togoreanbogdan/ADAU1446-DSP/README.md

# ADAU1446-DSP
Project for ADAU1446 Audio DSP. The PCB is compatible with all the family ADAU144x.
