togoreanbogdan/ADAU1446-DSP/KiCad/DSP-ADAU1446-core-pcb/DSP-ADAU1446-core-pcb.kicad_pcb

## KiCad design KiCad/DSP-ADAU1446-core-pcb/DSP-ADAU1446-core-pcb.kicad_pcb (2017-08-31)

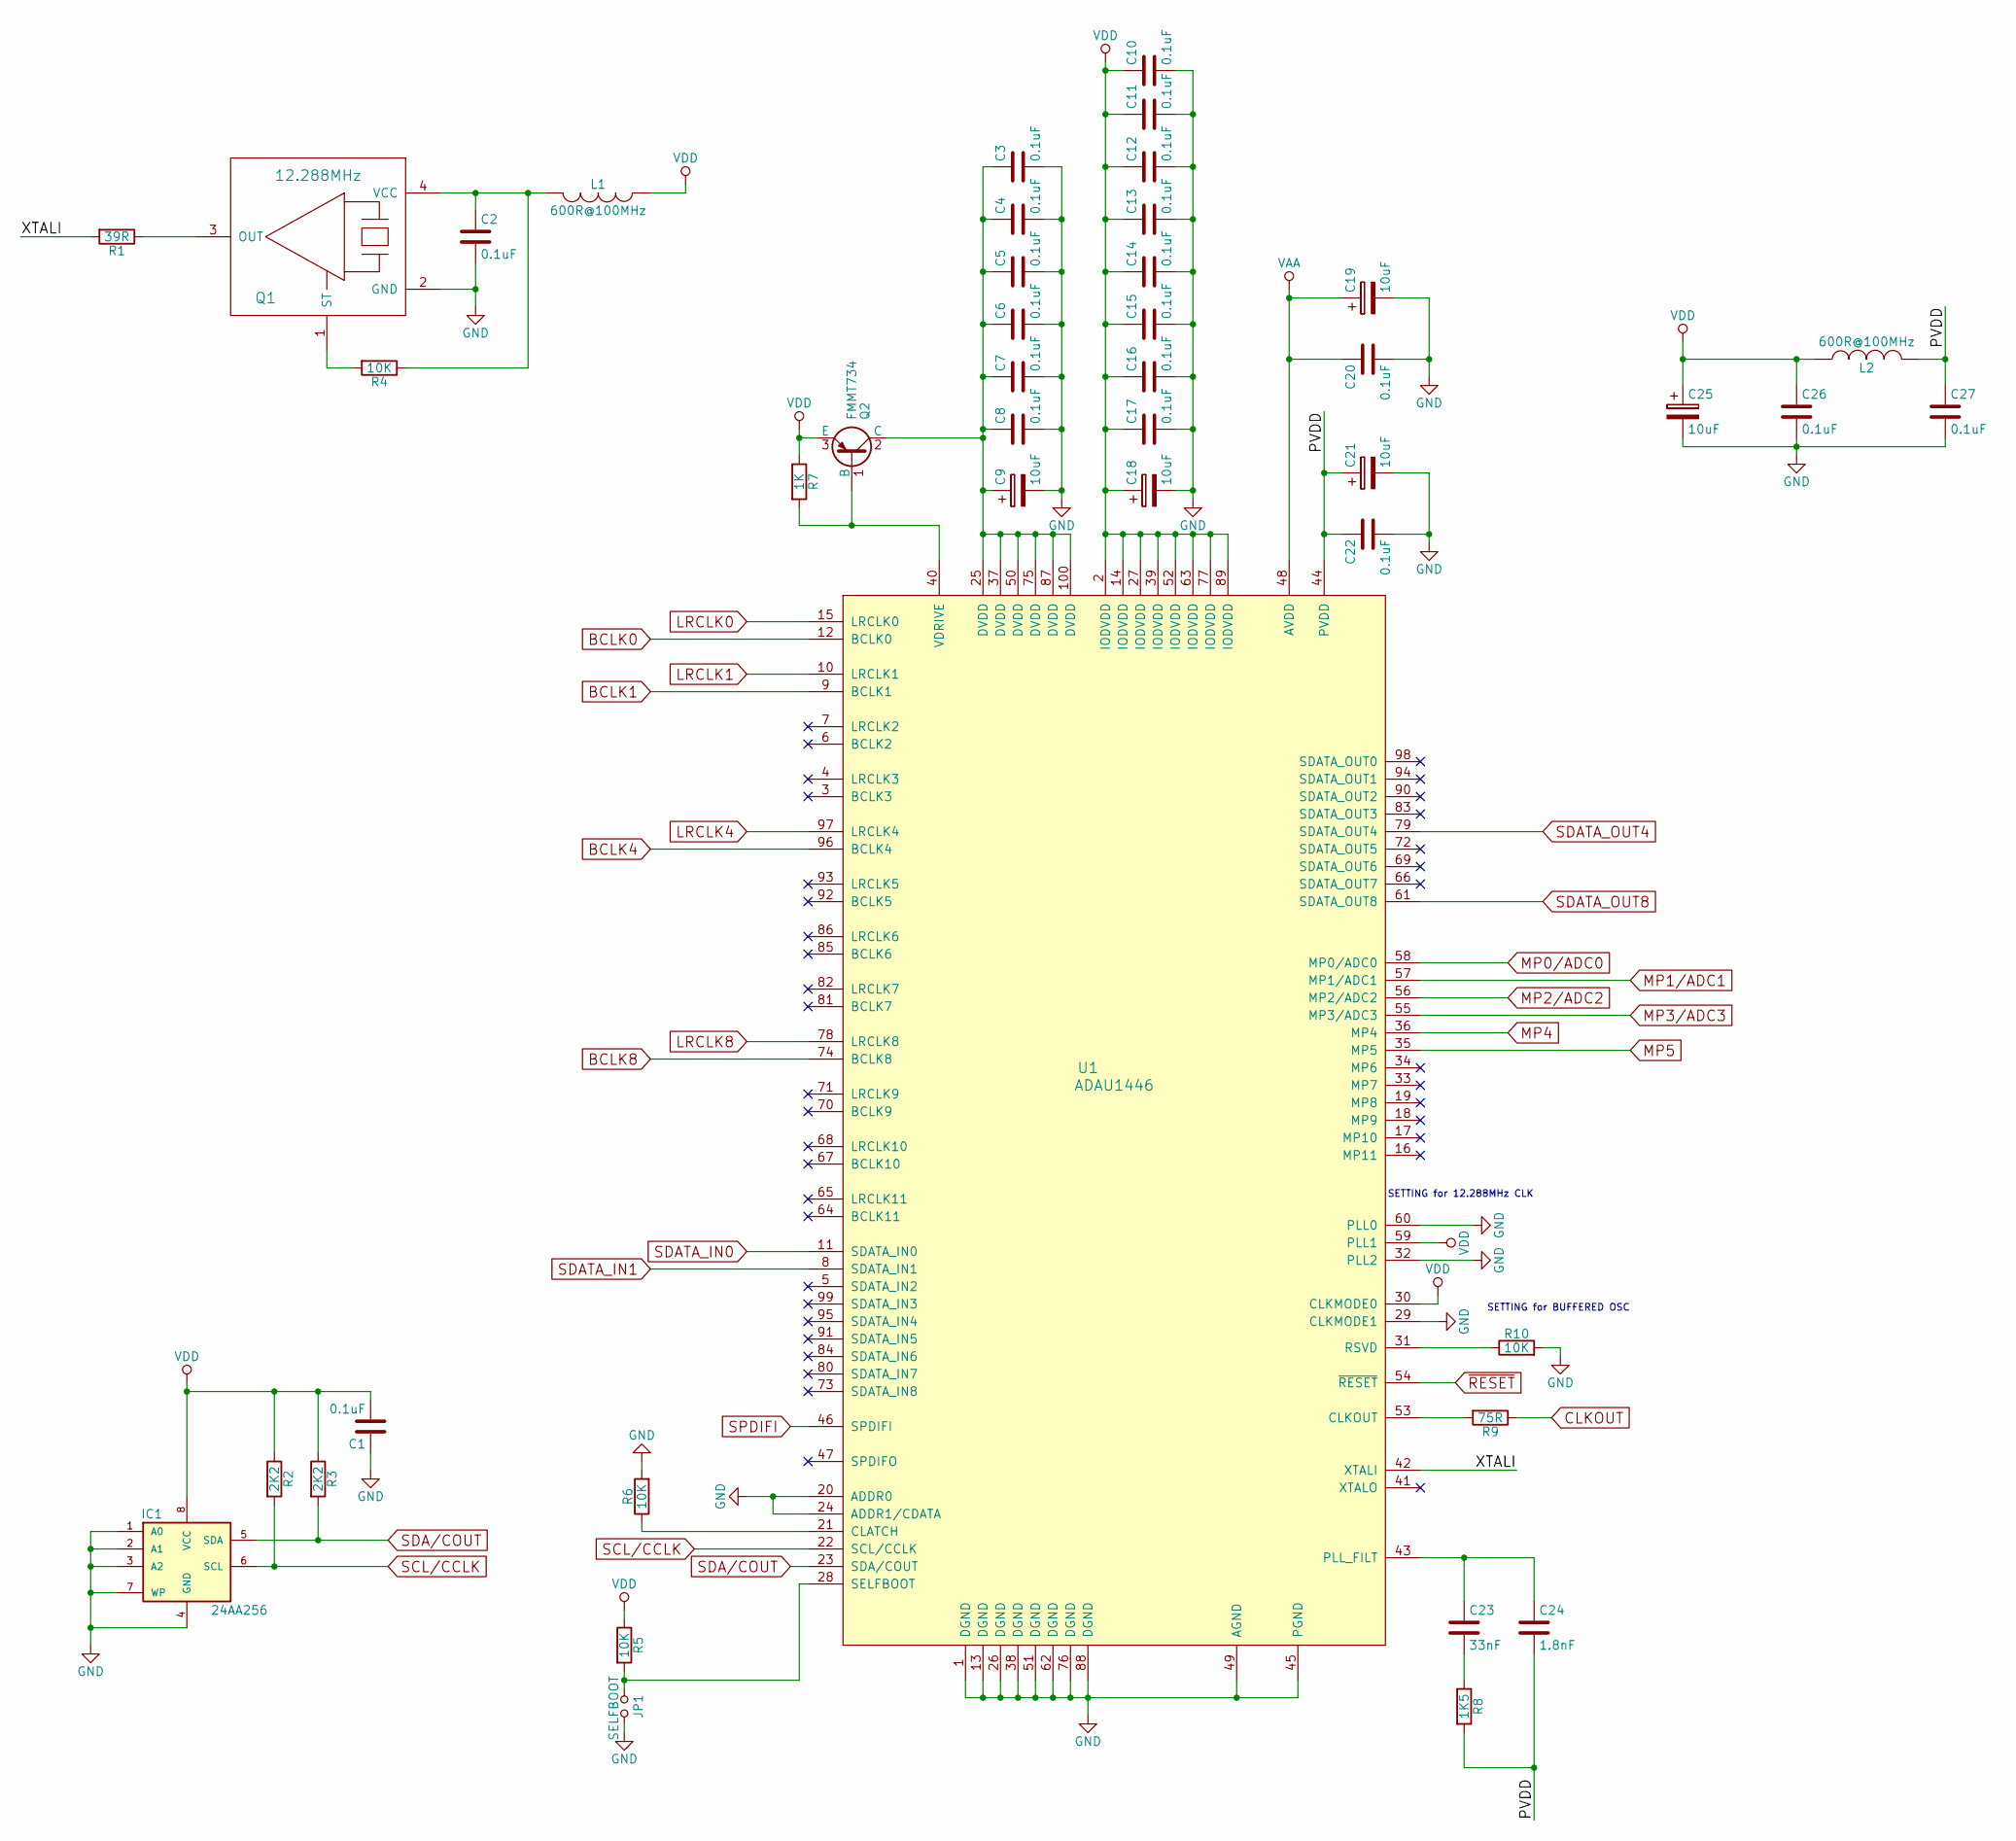
[picture p1: schematic ADAU1446.sch, ADAU1446 DSP]

Parts:
C1, C2, C3, C4, C5, C6, C7, C8, C10, C11, C12, C13, C14, C15, C16, C17, C20, C22, C26, C27: 0.1uF; c_0603
C9, C18: 10uF; c_elec_4x5.3; Mfr. Part No. EEE-FC1C100R
C19, C21, C25: 10uF; c_elec_4x5.3
C23: 33nF; c_0603
C24: 1.8nF; c_0603
IC1: 24AA256; so-8
JP1: SELFBOOT; pin_socket_2
L1, L2: 600R@100MHz; inductor_smd_0603
Q1: 12.288MHz; crystal_epson; Mfr. Part No. SG-210STF 12.2880ML3
Q2: FMMT734; sot23
R1: 39R; r_0603
R2, R3: 2K2; r_0603
R4, R5, R6, R10: 10K; r_0603
R7: 1K; r_0603
R8: 1K5; r_0603
R9: 75R; r_0603
U1: ADAU1446; TQFP-100

Connections:
/ADAU1446/PVDD: C21.1, C22.1, C24.2, C27.1, L2.2, R8.2, U1.44 (PVDD)
/ADAU1446/XTALI: R1.2, U1.42 (XTALI)
BCLK0: U1.12 (BCLK0); also elsewhere on the board
BCLK1: U1.9 (BCLK1); also elsewhere on the board
BCLK4: U1.96 (BCLK4); also elsewhere on the board
BCLK8: U1.74 (BCLK8); also elsewhere on the board
CLKOUT: R9.1; also elsewhere on the board
GND: C1.1, C2.2, C3.2, C4.2, C5.2, C6.2, C7.2, C8.2, C9.2, C10.2, C11.2, C12.2, C13.2, C14.2, C15.2, C16.2, C17.2, C18.2, C19.2, C20.2, C21.2, C22.2, C25.2, C26.2, C27.2, IC1.1 (A0), IC1.2 (A1), IC1.3 (A2), IC1.4 (GND), IC1.7 (WP), JP1.2, Q1.2 (GND), R6.2, R10.2, U1.1 (DGND), U1.13 (DGND), U1.20 (ADDR0), U1.24 (ADDR1/CDATA), U1.26 (DGND), U1.29 (CLKMODE1), U1.32 (PLL2), U1.38 (DGND), U1.45 (PGND), U1.49 (AGND), U1.51 (DGND), U1.60 (PLL0), U1.62 (DGND), U1.76 (DGND), U1.88 (DGND); also elsewhere on the board
LRCLK0: U1.15 (LRCLK0); also elsewhere on the board
LRCLK1: U1.10 (LRCLK1); also elsewhere on the board
LRCLK4: U1.97 (LRCLK4); also elsewhere on the board
LRCLK8: U1.78 (LRCLK8); also elsewhere on the board
MP0/ADC0: U1.58 (MP0/ADC0); also elsewhere on the board
MP1/ADC1: U1.57 (MP1/ADC1); also elsewhere on the board
MP2/ADC2: U1.56 (MP2/ADC2); also elsewhere on the board
MP3/ADC3: U1.55 (MP3/ADC3); also elsewhere on the board
MP4: U1.36 (MP4); also elsewhere on the board
MP5: U1.35 (MP5); also elsewhere on the board
unnamed: C2.1, L1.2, Q1.4 (VCC), R4.1
unnamed: C3.1, C4.1, C5.1, C6.1, C7.1, C8.1, C9.1, Q2.2 (C), U1.25 (DVDD), U1.37 (DVDD), U1.50 (DVDD), U1.75 (DVDD), U1.87 (DVDD), U1.100 (DVDD)
unnamed: C23.1, C24.1, U1.43 (PLL_FILT)
unnamed: C23.2, R8.1
unnamed: JP1.1, R5.2, U1.28 (SELFBOOT)
unnamed: Q1.1 (ST), R4.2
unnamed: Q1.3 (OUT), R1.1
unnamed: Q2.1 (B), R7.2, U1.40 (VDRIVE)
unnamed: R6.1, U1.21 (CLATCH)
unnamed: R9.2, U1.53 (CLKOUT)
unnamed: R10.1, U1.31 (RSVD)
SCL/CCLK: IC1.6 (SCL), R2.2, U1.22 (SCL/CCLK); also elsewhere on the board
SDA/COUT: IC1.5 (SDA), R3.2, U1.23 (SDA/COUT); also elsewhere on the board
SDATA_IN0: U1.11 (SDATA_IN0); also elsewhere on the board
SDATA_IN1: U1.8 (SDATA_IN1); also elsewhere on the board
SDATA_OUT4: U1.79 (SDATA_OUT4); also elsewhere on the board
SDATA_OUT8: U1.61 (SDATA_OUT8); also elsewhere on the board
SPDIFI: U1.46 (SPDIFI); also elsewhere on the board
VAA: C19.1, C20.1, U1.48 (AVDD); also elsewhere on the board
VDD: C1.2, C10.1, C11.1, C12.1, C13.1, C14.1, C15.1, C16.1, C17.1, C18.1, C25.1, C26.1, IC1.8 (VCC), L1.1, L2.1, Q2.3 (E), R2.1, R3.1, R5.1, R7.1, U1.2 (IODVDD), U1.14 (IODVDD), U1.27 (IODVDD), U1.30 (CLKMODE0), U1.39 (IODVDD), U1.52 (IODVDD), U1.59 (PLL1), U1.63 (IODVDD), U1.77 (IODVDD), U1.89 (IODVDD); also elsewhere on the board
~RESET: U1.54 (~RESET); also elsewhere on the board

Notes on the sheet:
SETTING for 12.288MHz CLK
SETTING for BUFFERED OSC

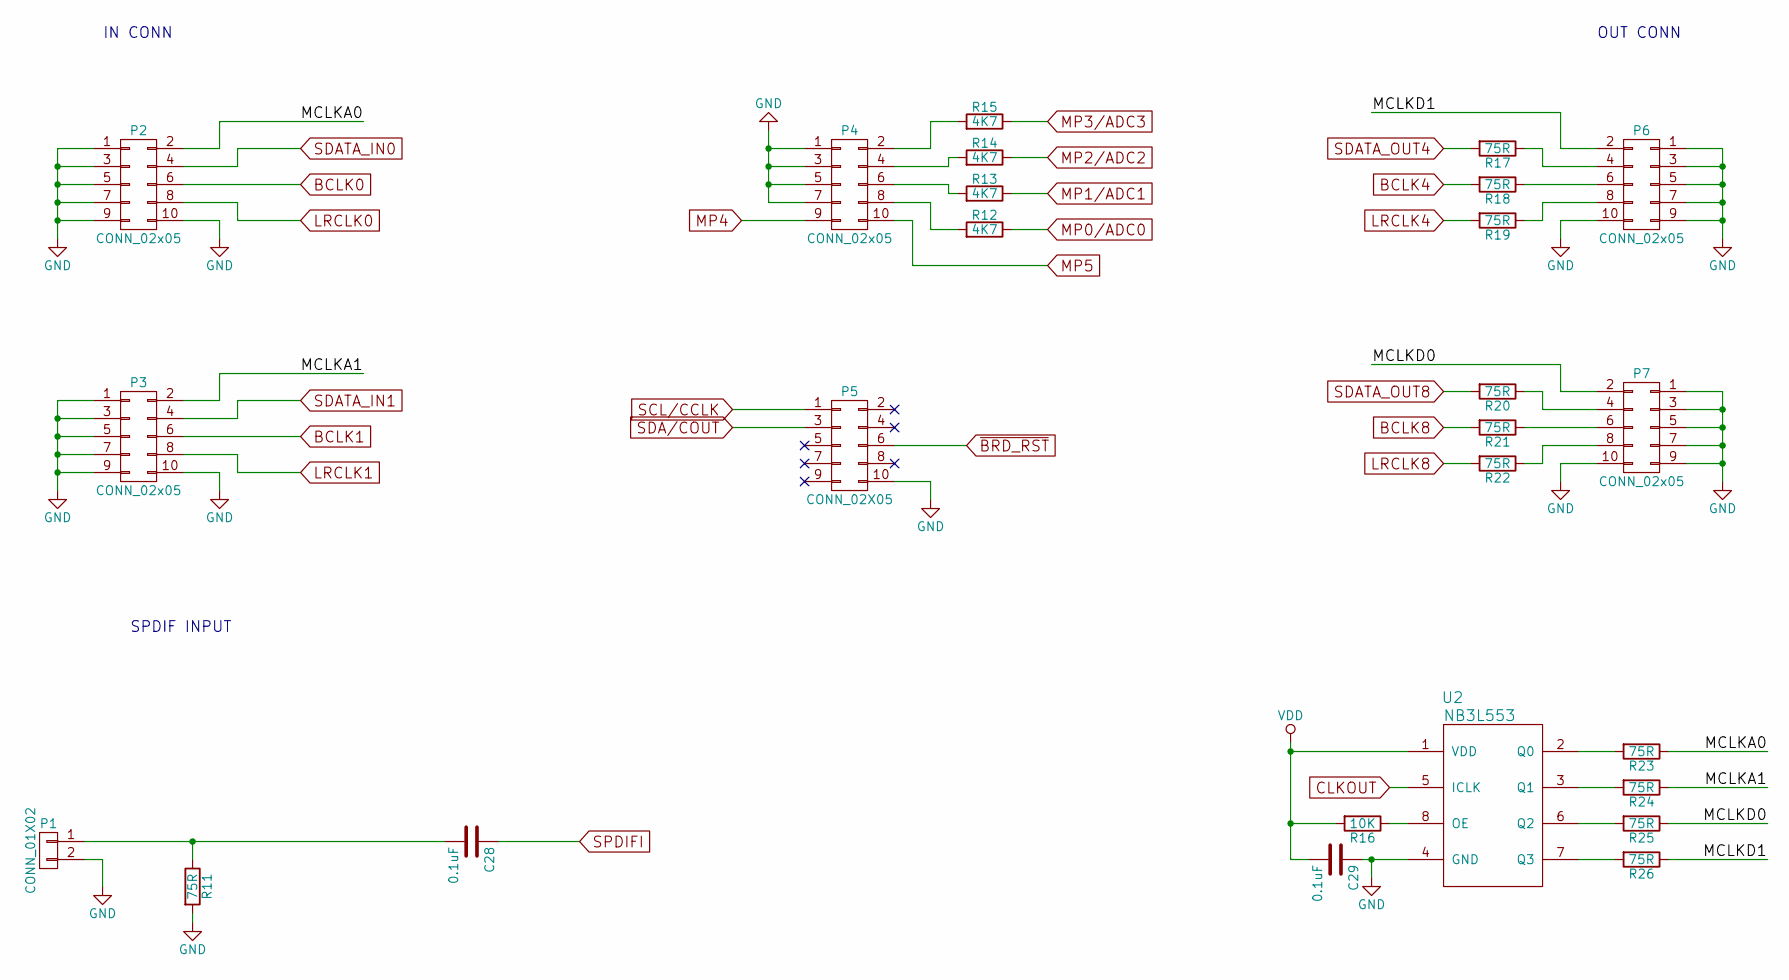
[picture p2: schematic CONN.sch]

Parts:
C28, C29: 0.1uF; c_0603
P1: CONN_01X02; Socket_Strip_Straight_1x02_Pitch2.54mm
P2, P3, P4, P6, P7: CONN_02x05; pin_strip_2mm_5x2; Mfr. Part No. DS1018-02-10B2
P5: CONN_02X05; pin_strip_2mm_5x2; Mfr. Part No. DS1018-02-10B2
R11, R17, R18, R19, R20, R21, R22, R23, R24, R25, R26: 75R; r_0603
R12, R13, R14, R15: 4K7; r_0603
R16: 10K; r_0603
U2: NB3L553; so-8; Mfr. Part No. NB3L553DG

Connections:
/CONN/MCLKA0: P2.2, R23.1
/CONN/MCLKA1: P3.2, R24.1
/CONN/MCLKD0: P7.2, R25.1
/CONN/MCLKD1: P6.2, R26.1
BCLK0: P2.6; also elsewhere on the board
BCLK1: P3.6; also elsewhere on the board
BCLK4: R18.2; also elsewhere on the board
BCLK8: R21.2; also elsewhere on the board
CLKOUT: U2.5 (ICLK); also elsewhere on the board
GND: C29.1, P1.2, P2.1, P2.3, P2.5, P2.7, P2.9, P2.10, P3.1, P3.3, P3.5, P3.7, P3.9, P3.10, P4.1, P4.3, P4.5, P4.7, P5.10, P6.1, P6.3, P6.5, P6.7, P6.9, P6.10, P7.1, P7.3, P7.5, P7.7, P7.9, P7.10, R11.2, U2.4 (GND); also elsewhere on the board
LRCLK0: P2.8; also elsewhere on the board
LRCLK1: P3.8; also elsewhere on the board
LRCLK4: R19.2; also elsewhere on the board
LRCLK8: R22.2; also elsewhere on the board
MP0/ADC0: R12.1; also elsewhere on the board
MP1/ADC1: R13.1; also elsewhere on the board
MP2/ADC2: R14.1; also elsewhere on the board
MP3/ADC3: R15.1; also elsewhere on the board
MP4: P4.9; also elsewhere on the board
MP5: P4.10; also elsewhere on the board
unnamed: C28.2, P1.1, R11.1
unnamed: P4.2, R15.2
unnamed: P4.4, R14.2
unnamed: P4.6, R13.2
unnamed: P4.8, R12.2
unnamed: P6.4, R17.1
unnamed: P6.6, R18.1
unnamed: P6.8, R19.1
unnamed: P7.4, R20.1
unnamed: P7.6, R21.1
unnamed: P7.8, R22.1
unnamed: R16.1, U2.8 (OE)
unnamed: R23.2, U2.2 (Q0)
unnamed: R24.2, U2.3 (Q1)
unnamed: R25.2, U2.6 (Q2)
unnamed: R26.2, U2.7 (Q3)
SCL/CCLK: P5.1; also elsewhere on the board
SDA/COUT: P5.3; also elsewhere on the board
SDATA_IN0: P2.4; also elsewhere on the board
SDATA_IN1: P3.4; also elsewhere on the board
SDATA_OUT4: R17.2; also elsewhere on the board
SDATA_OUT8: R20.2; also elsewhere on the board
SPDIFI: C28.1; also elsewhere on the board
VDD: C29.2, R16.2, U2.1 (VDD); also elsewhere on the board
~BRD_RST: P5.6; also elsewhere on the board

Notes on the sheet:
OUT CONN
IN CONN
SPDIF INPUT

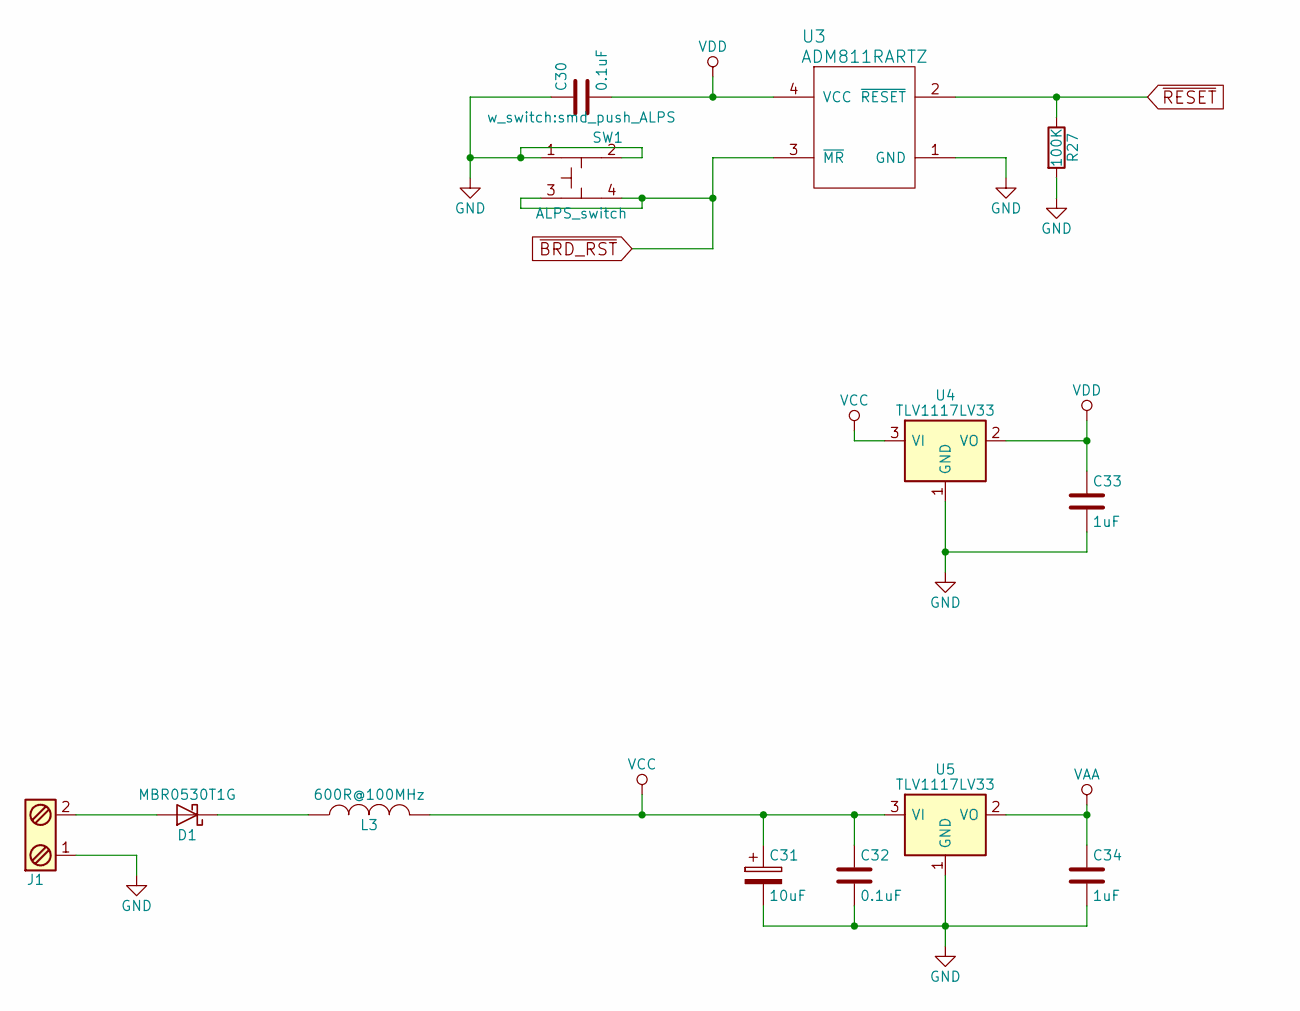
[picture p3: schematic PSU.sch]

Parts:
C30, C32: 0.1uF; c_0603
C31: 10uF; c_elec_4x5.3; Mfr. Part No. EEE-FC1C100R
C33, C34: 1uF; c_0805
D1: MBR0530T1G; sod123
J1: POW_CONN; mkds_1,5-2
L3: 600R@100MHz; inductor_smd_0603
R27: 100K; r_0603
SW1: ALPS_switch; smd_push_ALPS
U3: ADM811RARTZ; sot143B
U4, U5: TLV1117LV33; SOT-223-3Lead_TabPin2

Connections:
GND: C30.1, C31.2, C32.2, C33.2, C34.2, J1.1, R27.2, SW1.1, SW1.2, U3.1 (GND), U4.1 (GND), U5.1 (GND); also elsewhere on the board
unnamed: D1.1 (K), L3.1
unnamed: D1.2 (A), J1.2
VAA: C34.1, U5.2 (VO); also elsewhere on the board
VCC: C31.1, C32.1, L3.2, U4.3 (VI), U5.3 (VI)
VDD: C30.2, C33.1, U3.4 (VCC), U4.2 (VO); also elsewhere on the board
~BRD_RST: SW1.3, SW1.4, U3.3 (~MR); also elsewhere on the board
~RESET: R27.1, U3.2 (~RESET); also elsewhere on the board

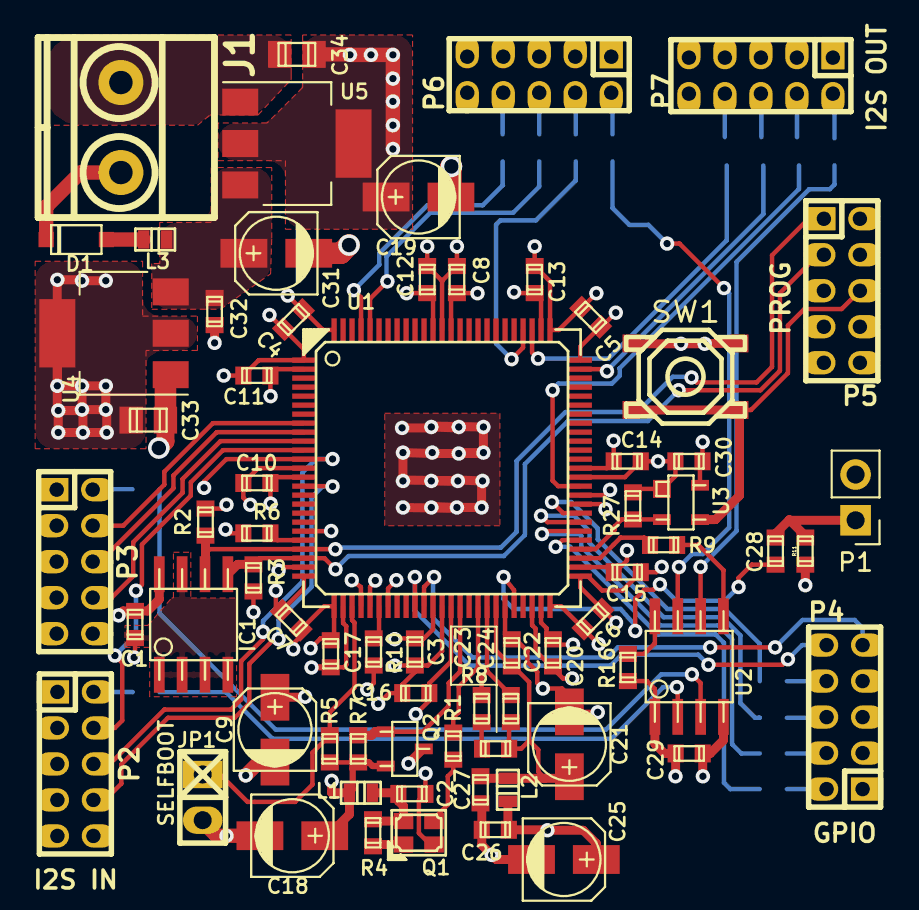
[picture p4: board DSP-ADAU1446-core-pcb.kicad_pcb from above]

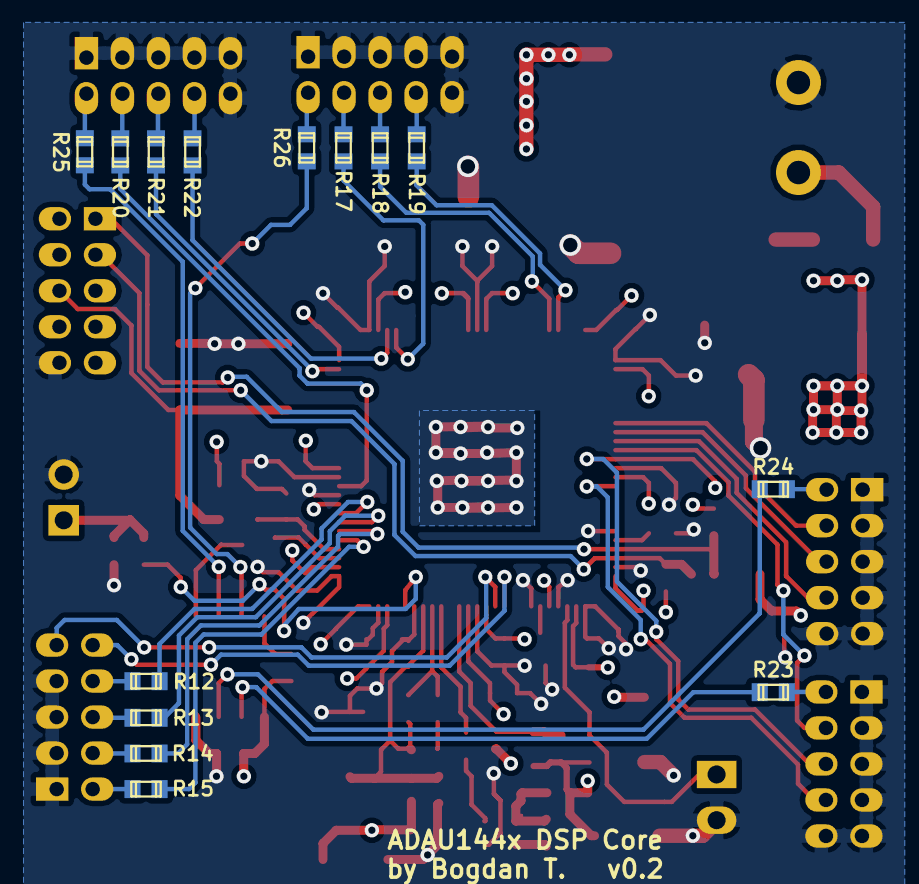
[picture p5: board DSP-ADAU1446-core-pcb.kicad_pcb from below]

Board: 4 copper layers, 83 parts (14 on the bottom side), 63 nets.
