togoreanbogdan/ADAU1446-DSP/(commit log)

2017-01-30 Initial commit. Work started on core DSP schematic
    [ADAU1446.sch, CONN.sch, DSP-ADAU1446-core-pcb.kicad_pcb, DSP-ADAU1446-core-pcb.sch, PSU.sch]
2017-01-30 - added switches library - updated ADAU1446 DSP core schematic
    [ADAU1446.sch, CONN.sch, DSP-ADAU1446-core-pcb.sch, PSU.sch]
2017-02-12 - finished schematics v0.1 - PCB work began - BOM generated
    [ADAU1446.sch, CONN.sch, DSP-ADAU1446-core-pcb.kicad_pcb, DSP-ADAU1446-core-pcb.sch, PSU.sch]
2017-02-19 - modifyed regulator transistor
    [ADAU1446.sch]
2017-02-19 - pcb development update
    [DSP-ADAU1446-core-pcb.kicad_pcb]
2017-02-20 Update .gitignore
    Allow track of BOM files
2017-02-22 -pcb update - changed footprint of IC1 and U2 to SO8
    [ADAU1446.sch, CONN.sch, DSP-ADAU1446-core-pcb.kicad_pcb]
2017-03-05 finished schematic and PCB for v0.1
    [CONN.sch, DSP-ADAU1446-core-pcb.kicad_pcb, PSU.sch]
2017-03-05 updated .gitnore to allow BOM .xml
2017-03-05 added production GERBER files
    [DSP-ADAU1446-core-pcb-B.Cu.gbl, DSP-ADAU1446-core-pcb-B.Mask.gbs, DSP-ADAU1446-core-pcb-B.SilkS.gbo, DSP-ADAU1446-core-pcb-Dwgs.User.gbr, DSP-ADAU1446-core-pcb-F.Cu.gtl, DSP-ADAU1446-core-pcb-F.Mask.gts, DSP-ADAU1446-core-pcb-F.SilkS.gto, DSP-ADAU1446-core-pcb.drl]
2017-03-05 updated .csv BOM
    [DSP-ADAU1446-core-pcb.csv]
2017-03-05 added Mouser Part Numbers BOM
    [DSP-ADAU1446-core-pcb_mouser.csv]
2017-08-31 Updated schematic and PCB to use SDATA_OUT4 and SDATA_OUT8 with LRCLK4,LRCLK8 and BCLK8,BCLK8
    [ADAU1446.sch, CONN.sch, DSP-ADAU1446-core-pcb.kicad_pcb]
2017-08-31 Added gerber files for V0.2
    [DSP-ADAU1446-core-pcb-B.Cu.gbl, DSP-ADAU1446-core-pcb-B.Mask.gbs, DSP-ADAU1446-core-pcb-B.SilkS.gbo, DSP-ADAU1446-core-pcb-Dwgs.User.gbr, DSP-ADAU1446-core-pcb-F.Cu.gtl, DSP-ADAU1446-core-pcb-F.Mask.gts, DSP-ADAU1446-core-pcb-F.SilkS.gto, DSP-ADAU1446-core-pcb.drl]
